dword1511/capttery/showcase_power/thunderboard_lp_0dbm.png

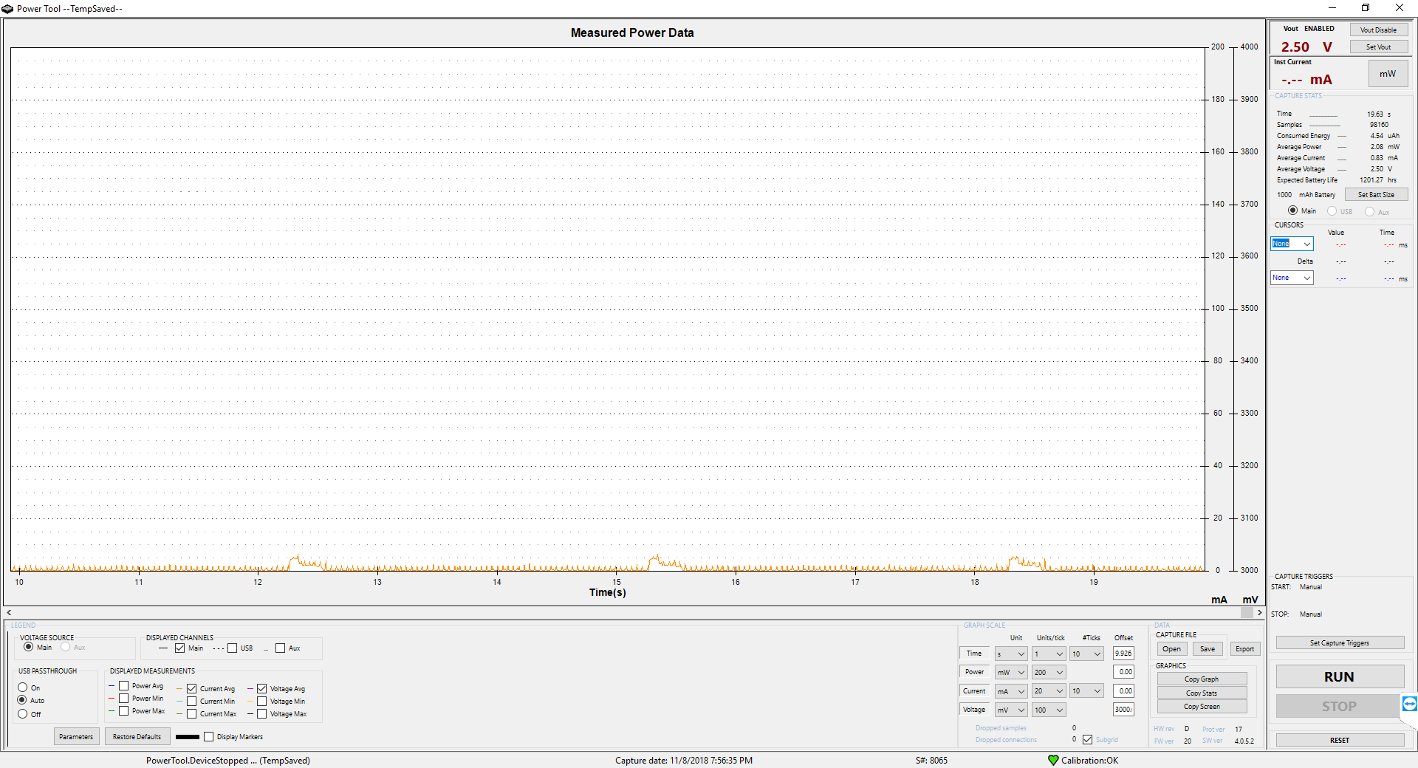
showcase_power/thunderboard_lp_0dbm.png
