dword1511/capttery/spice/new-tx-design.asc

C2: cap; {Clpf2 + Cmatch}; Rser={Rc2}
C3: cap; {Cgain}; Rser={Rc3}
C4: cap; {CM}
L2: ind; {Llpf2}; Rser={Rl2}
L3: ind; {Lmatch + Lgain}; Rser={Rl3}
R1: res; {RLeqv}
V1: voltage; PULSE(0 {VS} 0 100n 100n {1 / Fs / 2 - 100n} {1 / Fs})
Named nets: 0, vtx, va, vb
.param VS = 90
.param F = 1Meg
.param Rl2 = 0.5
.param Rc2 = 0.1
.param CM = 0.5p
.param RLeqv = 1k
.tran 0 5m 0 10n
.param Cgain = 110p
.param W = {2 * pi * F}
TODO: Chebshev filter and matching calculation
.param Lgain = {1 / (W * W * Cgain)}
NOTE: RLeqv does not matter much, impedance dominated by CM, then Cgain
NOTE: Max gain of Chebshev filter happens at around 0.94 omega_0
.param Lmatch = 31.3u
.param Cmatch = 797p
.param Llpf2 = 91.9u
.param Clpf2 = 217p
NOTE: filter output is 174 ohm
.step param Fs 980k 1020k 500
.meas TRAN Lgain_comp PARAM Lgain
.meas TRAN Vtxpp PP V(vtx)
.meas TRAN isrcpp PP I(V1)
.meas TRAN ilgpp PP I(L3)
NOTES:
24x36in plate to plate capacitance: 0.5pF @ 10m, 5pF @ 1m, 2.5pF @ 2m
All caps must be C0G dielectric and must satisfy the voltage & current ratings (see verification)
Actuall Cgain delopyed must take plate self-capacitance and probe capacitance into consideration
.param Fs 995.5k
.param Rl3 = 18
.param Rc3 = 0.5
.meas TRAN isrcavg AVG abs(I(V1))
Directions:
1. Determine Cgain based on parasitic coupling in the environment and available capacitor values. 100 pF is usually fine.
2. Determine desired F, VS, and VTX. CM and RLeqv are over-the-air capacitance and the RX load. They have limited impact on TX operation.
3. Amplitude of the current running through Cgain (Igain_pk) can be determined by VTX/Z(Cgain). Z(Cgain) = 1/(j2piFCgain).
4. Lgain can be determined by the resonance condition (see param statement). Since Lmatch is usually much smaller, you can make a few test inductors and get a sense of Rl3.
5. Estimate the power dissipated (Pd) based on (Rl3 * Igain^2)/2.
6. Compute the current supplied by VS based on Pd/VS. The output impedance of the supply (ZS) is hence VS^2/Pd.
7. Supply F and ZS to LC LPF design tool (e.g. https://www-users.cs.york.ac.uk/~fisher/lcfilter/, where ZS used as the filter's characteristic impedance).
8. Choose a 2nd-order 3-dB Chebshev filter that starts with a series element. You may tune the filter parameters a bit so F gets maximum amplitude while 3*F gets good antennuation.
9. The filter tool will tell you Llpf2, Clpf2, and the output impedance (Zlpf2) of the filter.
10. Design the matching stage with tools (e.g. https://home.sandiego.edu/~ekim/e194rfs01/jwmatcher/matcher2.html) such that the output is matched to Rl3 (assuming Rl2 and cap ESR negligible).
11. Choose a topology starts with a shunt cap. The matching stage tool will tell you Lmatch and Cmatch.
12. Run the sweep simulation to see the actual VTX and optimal frequency (see http://ltwiki.org/index.php?title=Parametric_plot_(plot_measurements_in_relation_to_a_swept_parameter)).
13. You may need to change the sweep range, do a coarse one first, and then a fine-grained one. You can then tune the system back and forth.
