dword1511/capttery/spice/new-tx-verify.asc

C1: cap; 4.3n; Rser={Rc2}
C2: cap; 110p; Rser={Rc3}
C3: cap; 0.5p
L1: ind; 10.3µ; Rser={Rl2}
L2: ind; 238µ; Rser={Rl3}
R1: res; 1k
V1: voltage; PULSE(0 {VS} 0 100n 100n {1 / Fs / 2 - 100n} {1 / Fs}); AC {VS}
Named nets: 0, vtx, va, vb
.param Fs 1004k
.param Rl2 0.5
.param Rc3 1
.tran 0 5m 0 100n
.param VS 30
.step param Fs 950k 1050k 1k
.ac lin 10000 500k 1.5Meg
.meas TRAN vtxpp PP V(vtx)
.param Rl3 12
.param Rc2 1
NOTE: use this simulation setup to verify the voltage and current rating requirements for components.
Please leave sufficient margin (suggest at least 50%) when implementing.
