dword1511/capttery/spice/rx_p_vs_rl.asc

C1: cap; {CM * 2}
C2: cap; {C}
C3: cap; {CM * 2}
C4: cap; {CF}
C5: cap; {Cpar}
D1: diode; NSR0340
D2: diode; NSR0340
L1: ind; {L}
R1: res; 1e15
R2: res; {RL}
R3: res; {Rac}
V1: voltage; SINE(0 {VTX} {F})
Named nets: 0, rxp, rxn, La, Lb
.MODEL NSR0340 d IS=1.38871e-07 RS=0.510993 N=1.05446
+ EG=0.708435 XTI=0.5 BV=1000 IBV=0.0001 CJO=3.20087e-11
+ VJ=0.4 M=0.467082 FC=0.5 TT=6.49213e-09 KF=0 AF=1
.tran 0 6m 1m
.step param RL 100 2k 20
.param L = 270u
.param C = {1 / (W * W * L)}
.param F = 1Meg
.meas TRAN Pout AVG ((V(rxp)-V(rxn))*I(R2))
.meas tran Comp_C param C
.param W = {2 * pi * F}
.param CF = {0.1m / RL}
.param Q = 55
.param SRF = 7Meg
.param SRW = {2 * pi * SRF}
.param Cpar = {1 / (SRW * SRW * L)}
Approximation assumes large SRF/F ratio
.param Rac = {2 * pi * QF * L / Q}
.param QF = 790k
.meas tran Comp_CF param CF
.meas tran Comp_Cpar param Cpar
.meas tran Comp_Rac param Rac
R1 for avoiding floating nets
CF is storage cap, whose value is set according to fixed time constant
Inductor model
.param CM = 0.5p
.param VTX = 3200
Sweep simulation for RX
See: http://ltwiki.org/index.php?title=Parametric_plot_(plot_measurements_in_relation_to_a_swept_parameter)
Setup CM, VTX, and RL's range accordingly before running.
Value of C2 will be computed automatically. It includes both parasitics (e.g. plate self capacitance, diode junction capacitance) and intentionally added capacitors.
