dword1511/capttery/(commit log)

2019-06-09 ble showcase and power trace screenshot
2019-08-01 add voltage meter and HV probe
